FOXSPEED99/BleuLand-Smart-Energy-Meter/Bleu-Land/Smart-Energy-Meter/Enclosure/Labels/front_label_80x41mm_DIECUT.pdf

DIE-CUT: outline R1.5, LED holes Ø3.2 (rods Ø3.0)
