FOXSPEED99/BleuLand-Smart-Energy-Meter/Bleu-Land/Smart-Energy-Meter/Enclosure/Labels/rating_label_46x32mm.pdf

SEM-1 S M A R T E N E R G Y M E T E R

Supply | 230 V~ 50 Hz, ≤ 3 W
Measuring | 1-phase · CT 100 A / 50 mA (max 80 A)
Internal fuse T500mA L 250 V (5×20 ceramic)
Radio | Wi-Fi 2.4 GHz 802.11 b/g/n
Environment IP20 · −10 … +50 °C · indoor
Mounting EN 60715 TS35 · 5 modules
