FOXSPEED99/BleuLand-Smart-Energy-Meter/Bleu-Land/Smart-Energy-Meter/Enclosure/Labels/front_label_80x41mm.pdf

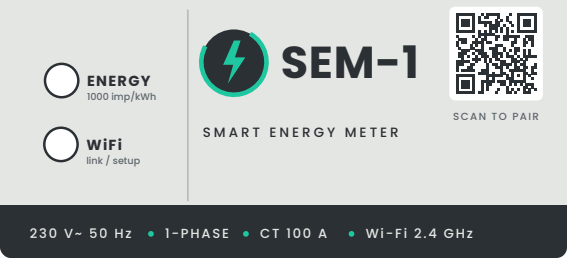
[picture p1: figure]
ENERGY; WiFi; 1000 imp/kWh; link / setup; SEM-1; SCAN TO PAIR; 1-PHASE; Wi-F i 2.4 GHz
