FOXSPEED99/BleuLand-Smart-Energy-Meter/Bleu-Land/Smart-Energy-Meter/Enclosure/Labels/front_label_80x41mm_DIECUT.png

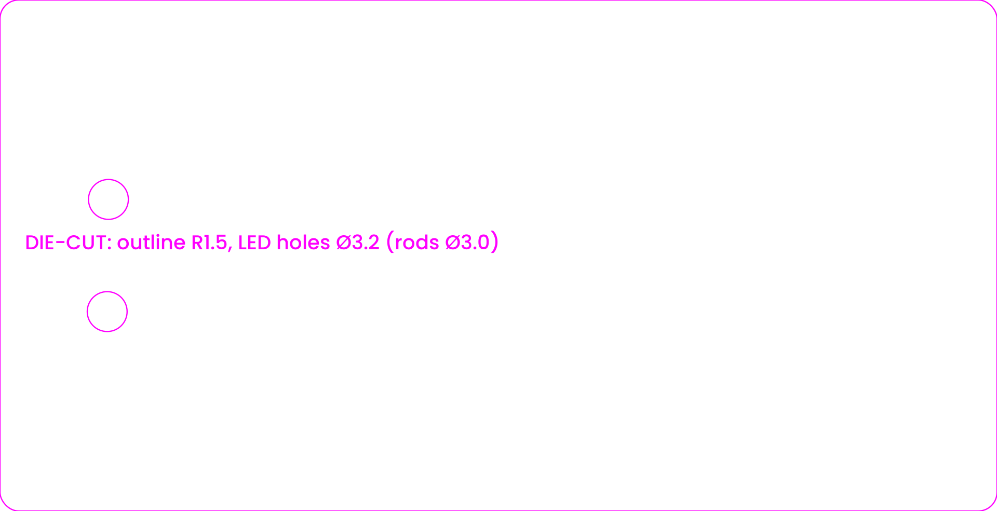
Bleu-Land/Smart-Energy-Meter/Enclosure/Labels/front_label_80x41mm_DIECUT.png
