FOXSPEED99/BleuLand-Smart-Energy-Meter/Bleu-Land/Smart-Energy-Meter/Enclosure/Labels/rating_label_46x32mm.png

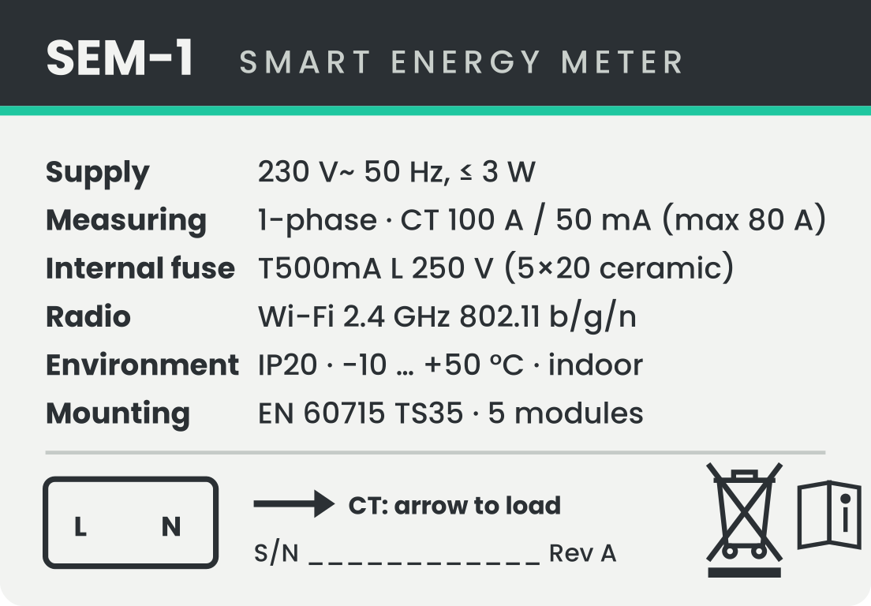
Bleu-Land/Smart-Energy-Meter/Enclosure/Labels/rating_label_46x32mm.png
