FOXSPEED99/BleuLand-Smart-Energy-Meter/Bleu-Land/Smart-Energy-Meter/Enclosure/Renders/SEM-1_front.png

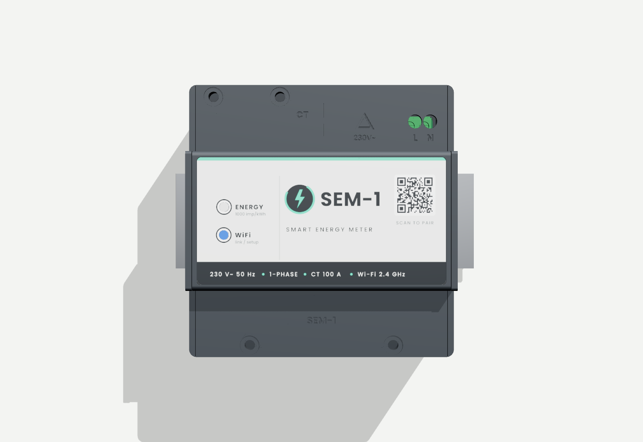
Bleu-Land/Smart-Energy-Meter/Enclosure/Renders/SEM-1_front.png
