FOXSPEED99/BleuLand-Smart-Energy-Meter/Bleu-Land/Smart-Energy-Meter/Enclosure/Renders/SEM-1_top.png

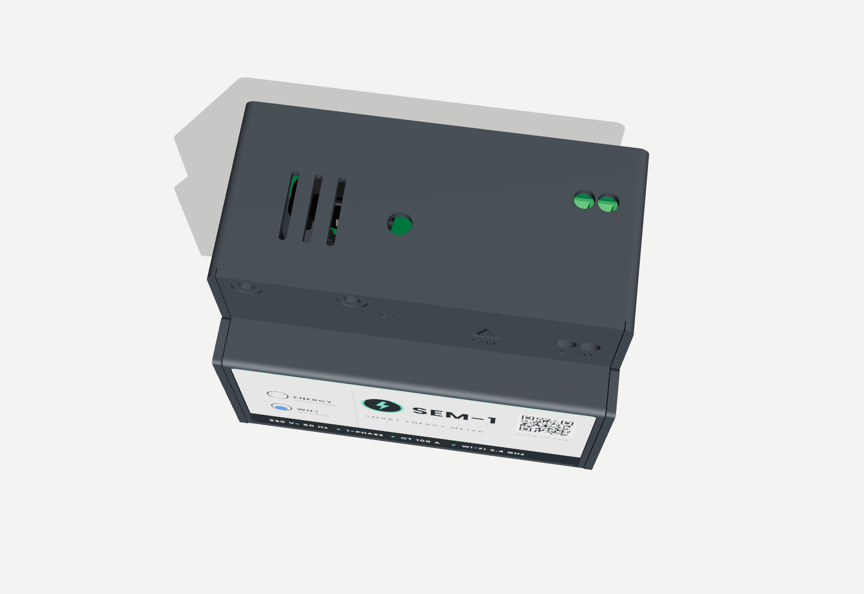
Bleu-Land/Smart-Energy-Meter/Enclosure/Renders/SEM-1_top.png
