FOXSPEED99/BleuLand-Smart-Energy-Meter/Bleu-Land/Smart-Energy-Meter/Smart-Energy-Meter_BOM_revA.xlsx

Sheet: PCB parts
Smart Energy Meter rev A: Bill of Materials
Meters to build: |  | 10 | ← edit this number (yellow); "Qty to order" updates. Source: Energy-Meter.SchDoc, 4 Oct 2026.
Line | Designators | Qty / meter | Value | Description | Manufacturer | Manufacturer Part Number | Footprint | Notes | Qty to order
1 | BT1 | 1 | BATT holder | BATTERY HOLDER COIN 20MM PC PIN | MPD | BH32T-C-G | BAT_BH32T-C-G | Holder only; CR2032 on Off-board sheet | 10
2 | C1 | 1 | 10 µF | General Purpose Ceramic Capacitor, 1206, 10uF, 10%, X5R, 15%, 10V | KYOCERA AVX | 1206ZD106KAT2A | FP-1206-L_3_2_0_2-W_1_6_0-MFG |  | 10
3 | C2, C6, C8 | 3 | 100 nF | CAP CER 0.1UF 25V X7R 1206 | KEMET | C1206C104J3RACTU | FP-C1206C-EB-MFG |  | 30
4 | C3 | 1 | 470uF | Capacitor, aluminium electrolytic, 470 uF, 10 V, 20%, radial D8x11.5mm, 3.5mm pitch, laid down | Rubycon | 10YXF470MEFC8X11.5 | CAPPRD350W60D800H1150_LAYDOWN | Mounted lying flat under the ESP32 | 10
5 | C4 | 1 | 100 nF | AR 100nF Ceramic Multilayer Cap,50V dc,+125C,X7R Dielectric,+/-10%,Through Hole AVX AR215C104K4R | AVX | AR215C104K4R | CAPRR508W50L508T318H762 |  | 10
6 | C5 | 1 | 0.1uF X2 | Capacitor 0.1uF +/-10%, 275 VAC class X2, MKP polypropylene film, 40/100/21, radial through hole, 15 mm pitch | TDK | B32922C3104K000 | CAPX2_L18.0-W6.0-H11.0_P15.00 | X2 safety cap, 305 VAC, 15 mm pitch | 10
7 | C7 | 1 | 10 µF | Chip Multilayer Ceramic Capacitors for General Purpose, 1206, 10uF, X7R, 15%, 10%, 25V | Murata | GRM31CR71E106KA12L | FP-GRM31C-0_2-e0_3_0_8-IPC_C |  | 10
8 | C9, C10 | 2 | 33 nF | CAP 33nF 50V ±5% 1206 (3216 Metric) Thickness 1.7mm SMD | Murata | GRM3195C1H333JA01D | CAPC1206(3216)170_N | C0G (stable filter cap) | 20
9 | C11, C12 | 2 | 10 nF | CAP CER 1206 .01UF 25V X7R 5% AU | KEMET | C1206C103J3RACAUTO | FP-C1206C-EB-MFG |  | 20
10 | D1 | 1 | LED 3mm Blue | LED, 3mm round, blue diffused, THT 2.54mm | Kingbright | WP710A10QBD/D | LED_D3.0MM_P2.54_BLUE | Blue, D1 only (active-low drive from 5 V) | 10
11 | D2 | 1 | LED 3mm White | LED, 3mm round, white diffused, THT 2.54mm | Kingbright | L-7104QWC-D | LED_D3.0MM_P2.54_WHITE | White, D2 only (active-low drive from 5 V) | 10
12 | D3, D4 | 2 | SMAJ5.0CA | TVS DIODE 5V 9.2V SMA | Bourns Inc. | SMAJ5.0CA | FP-SMAJ-MFG |  | 20
13 | F1 | 1 | Holder 5x20 + T500mA 250V | 5mm Slim Line Fuse holder | Keystone | 4628 | FUSE_4628 | Holder only; fuse insert on Off-board sheet | 10
14 | FB1 | 1 | Ferrite Bead | Chip Ferrite Bead, 1206, 600O @ 100MHz, 0.038O, 25%, 2.9A | Murata | BLM31KN601SN1L | FP-BLM31-0_2-T1_6-IPC_B |  | 10
15 | IC1 | 1 | DS1307 | Real Time Clock (RTC) I²C, 56 B RAM, 8-DIP | Analog Devices | DS1307+ | DIP794W47P254L991H457Q8 |  | 10
16 | J1 | 1 | B2B-XH-A | CONN HEADER VERT 2POS 2.5MM | JST | B2B-XH-AM(LF)(SN) | FP-B2B-XH-AM_LF_SN-MFG | CT connector on PCB | 10
17 | L1 | 1 | 744821110 |  | Wurth Elektronik | 744821110 | WE-CMB_Type XS_L15W7.5H18 | Common-mode choke 10 mH | 10
18 | P1 | 1 | Terminal Block | PCB terminal block, 2 positions, 5.08 mm pitch, through hole | TE Connectivity | 282837-2 | TE_282837-2 |  | 10
19 | PS1 | 1 | HLK-5M05 | AC DC 220V to 5V 5W 5Watt Isolated Switching Step-Down Power Supply Module Converter | Hi-link | HLK-5M05 | CONV_HLK-5M05 |  | 10
20 | R1, R9 | 2 | 330Ω | RES SMD 330 OHM 5% 1W 2512 | Yageo | AC2512JK-07330RL | FP-AC2512-MFG |  | 20
21 | R2, R3 | 2 | 4.7kΩ | RES SMD 4.7K OHM 1% 1W 2512 | Yageo | AC2512FK-074K7L | FP-AC2512-MFG |  | 20
22 | R4 | 1 | 100Ω | Res MC AT Precision Thin Film 1206 100O 0.1% 0.4W ±25ppm/°C Molded Paper T/R | Vishay | MCA1206MD1000BP100 | FP-MCA1206-IPC_A | ZMPT101B burden, 0.1% 25 ppm (check packaging suffix when ordering) | 10
23 | R5, R8, R10, R13 | 4 | 47k | Resistor, 47 kOhm, 1%, 0.25 W, metal film, axial THT, 7.62 mm pitch | YAGEO | MFR-25FRF52-47K | RESAD762W55L630D240_MF | Mains divider, metal film 1% | 40
24 | R6 | 1 | 2kΩ | RES Thick Film, 2kO, 1%, 1W, 100ppm/°C, 2512 | Vishay | CRCW25122K00FKEG | FP-CRCW2512-E3-IPC_A |  | 10
25 | R7 | 1 | 0Ω | 0O ±0 1W 2512 Thick Film Chip Resistor AEC-Q200 compliant | Stackpole | RMCF2512ZT0R00 | FP-RMCF2512-IPC_A |  | 10
26 | R11 | 1 | 1kΩ | RES Thick Film, 1kO, 1%, 1W, 100ppm/°C, 2512 | Vishay | CRCW25121K00FKEH | FP-CRCW2512-E3-IPC_A |  | 10
27 | R12 | 1 | 1kΩ | 1kO ±1% 0.25W 1206 Thick Film Chip Resistor AEC-Q200 compliant | Stackpole | RMCF1206FT1K00 | FP-RMCF1206-IPC_C |  | 10
28 | R14 | 1 | 0.5Ω | Chip Resistor, 0.5 Ohm, +/- 1%, 1 W, -65 to 275 degC, 2512 (6432 Metric), RoHS, Tape and Reel | Vishay | WSLT2512R5000FEA | RESC6432X89X76ML25T25 | CT burden, 0.5 Ω metal strip (100 A rating) | 10
29 | R15, R17 | 2 | 1.5kΩ | RES Thick Film, 1.5kO, 1%, 1W, 100ppm/°C, 2512 | Vishay | CRCW25121K50FKEG | FP-CRCW2512-E3-IPC_A |  | 20
30 | RV1 | 1 | MOV-10D561K | 560 V 2.5 kA Varistor 1 Circuit Through Hole Disc 10mm | Bourns | MOV-10D561K | VAR_MOV-10D561K |  | 10
31 | T1 | 1 | ZMPT101B | Current-type Voltage Transformer | Qingxian Zeming Langxi Electronic | ZMPT101B | XFMR_ZMPT101B |  | 10
32 | U1 | 1 | ESP32-DevKitC V4 | Espressif ESP32-DevKitC V4 (ESP32-WROOM-32E) dev board, socketed on 2x19 female headers | Espressif Systems | ESP32-DEVKITC-32E | ESP32-DEVKITC-V4_SOCKET | Plugs into 2 female headers (Off-board sheet) | 10
33 | U2 | 1 | HLW8032 | High-precision single-phase energy metering IC, dual sigma-delta ADC, UART 4800bps, PF pulse output, 5V, SOP-8 | Hiliwei Tech | HLW8032 | SOIC127P600X175-8N | LCSC C128023 | 10
34 | Y1 | 1 | 32.768kHz | Crystal 32.768 kHz, 12.5 pF, +/-20 ppm, tuning fork, 3 x 8 mm cylindrical can, through hole, vertical | Abracon | AB38T-32.768KHZ | XTAL_D3.2XL8.3_P2.00_VERTICAL |  | 10
 | Total parts per meter | 45

Sheet: Off-board items
Items you buy but do not solder as a schematic part
Meters to build: |  | 10
Line | Item | Qty / meter | Manufacturer | Manufacturer Part Number | Goes with | Notes | Qty to order
1 | Fuse 5×20 mm, T500 mA, 250 VAC, ceramic, time-lag | 1 | Littelfuse | 0215.500MXP | F1 holder | HLK-5M05 datasheet value | 10
2 | Lithium coin cell 3 V | 1 | Panasonic | CR2032 | BT1 holder | RTC backup | 10
3 | Split-core current transformer 100 A : 50 mA (current output, no internal burden) | 1 | YHDC | SCT-013-000 | J1 | Cut the 3.5 mm jack; crimp JST XH (tip wire → pin 2, sleeve wire → pin 1) | 10
4 | Female header 1×19, 2.54 mm, 8.5 mm tall | 2 | Sullins | PPTC191LFBN-RC | U1 (ESP32 DevKitC socket) | Check height: DevKitC must sit ≥ 9 mm above board for C3 | 20
5 | JST XH housing, 2 pin | 1 | JST | XHP-2 | CT cable to J1 |  | 10
6 | JST XH crimp contact, 22–28 AWG | 2 | JST | SXH-001T-P0.6 | CT cable to J1 | Order spares | 20
7 | Bare PCB 75 × 75 mm, FR-4 1.6 mm, 2 layers, 1 oz, HASL | 1 | (PCB maker) | Energy-Meter rev A | — | Order after Round K (release files) | 10
8 | DIN-rail enclosure | 1 | TBD | TBD (Round F) | — | Chosen in Round F | 10
