FOXSPEED99/BleuLand-Smart-Energy-Meter/Bleu-Land/Smart-Energy-Meter/Enclosure/STEP/SEM-1_enclosure_assembly.step

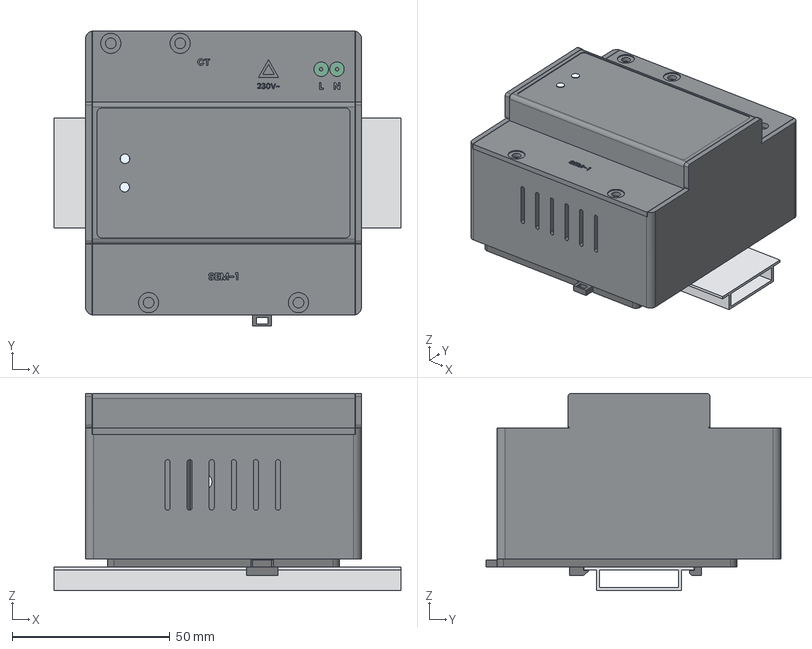
[picture p12: CAD file, 2026-10-08]
Bleu-Land/Smart-Energy-Meter/Enclosure/STEP/SEM-1_enclosure_assembly.step
110.0 x 93.5 x 62.5 mm
base
cover
din_foot
lightpipe_carrier
light_rods_PMMA
PCB_bare
TS35_rail_reference
