FOXSPEED99/BleuLand-Smart-Energy-Meter/Bleu-Land/Smart-Energy-Meter/Enclosure/STEP/base.step

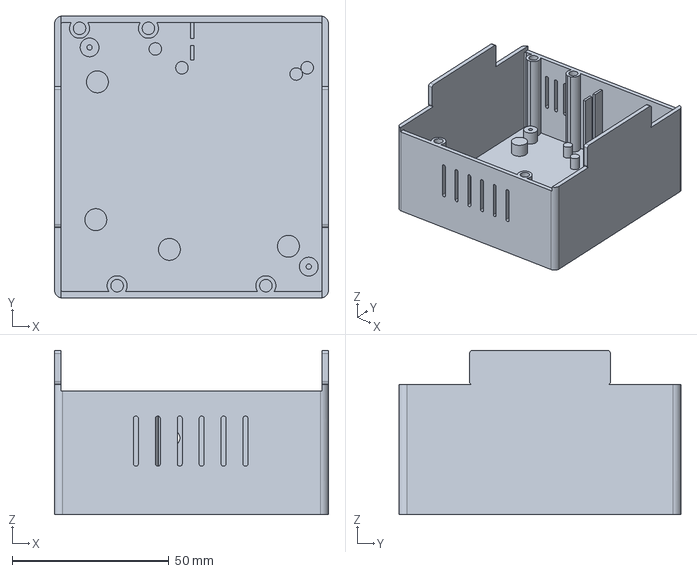
[picture p13: CAD file, 2026-10-08]
Bleu-Land/Smart-Energy-Meter/Enclosure/STEP/base.step
87.5 x 90.0 x 52.5 mm
