FOXSPEED99/BleuLand-Smart-Energy-Meter/Bleu-Land/Smart-Energy-Meter/Enclosure/STL_print_ready/03_din_foot__print_rail_side_up_PETG.stl

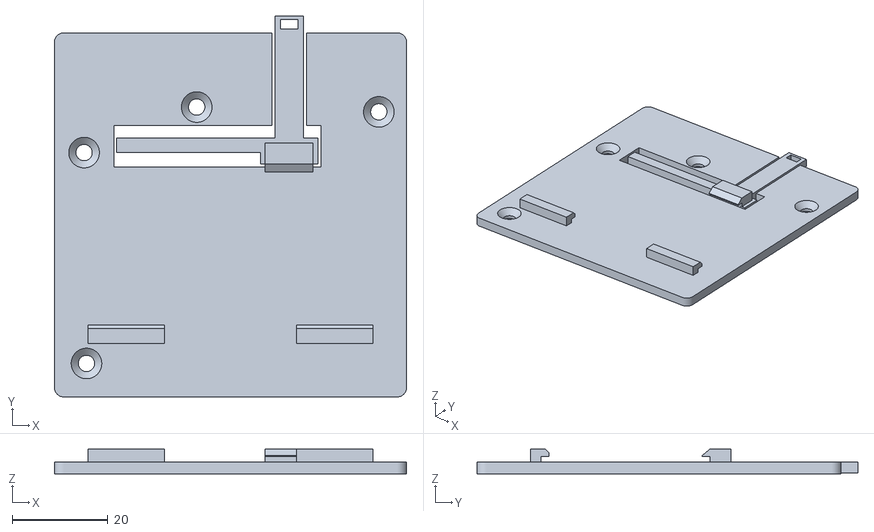
[picture p14: CAD file, 2026-10-08]
Bleu-Land/Smart-Energy-Meter/Enclosure/STL_print_ready/03_din_foot__print_rail_side_up_PETG.stl
73.5 x 79.5 x 5.20
