FOXSPEED99/BleuLand-Smart-Energy-Meter/Bleu-Land/Smart-Energy-Meter/Enclosure/STEP/lightpipe_carrier.step

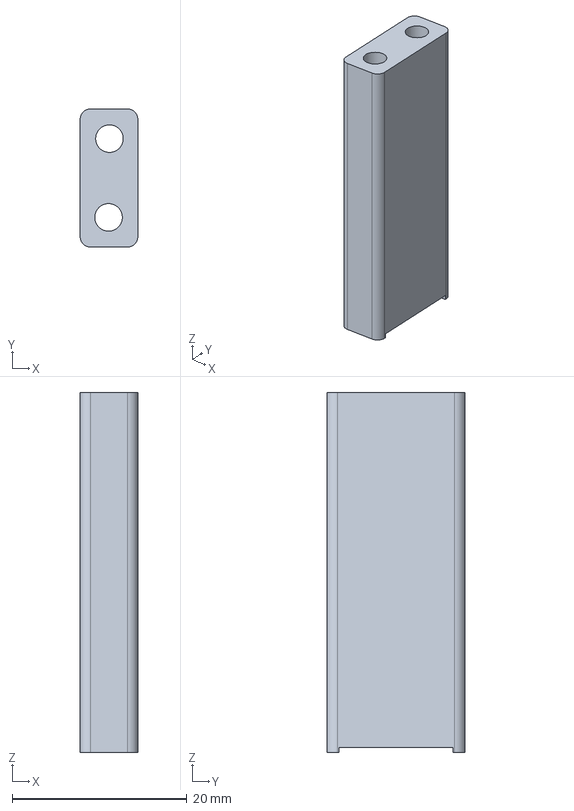
[picture p15: CAD file, 2026-10-08]
Bleu-Land/Smart-Energy-Meter/Enclosure/STEP/lightpipe_carrier.step
6.60 x 15.8 x 41.1 mm
