FOXSPEED99/BleuLand-Smart-Energy-Meter/Bleu-Land/Smart-Energy-Meter/Enclosure/STL_print_ready/02_cover__print_standing_on_end.stl

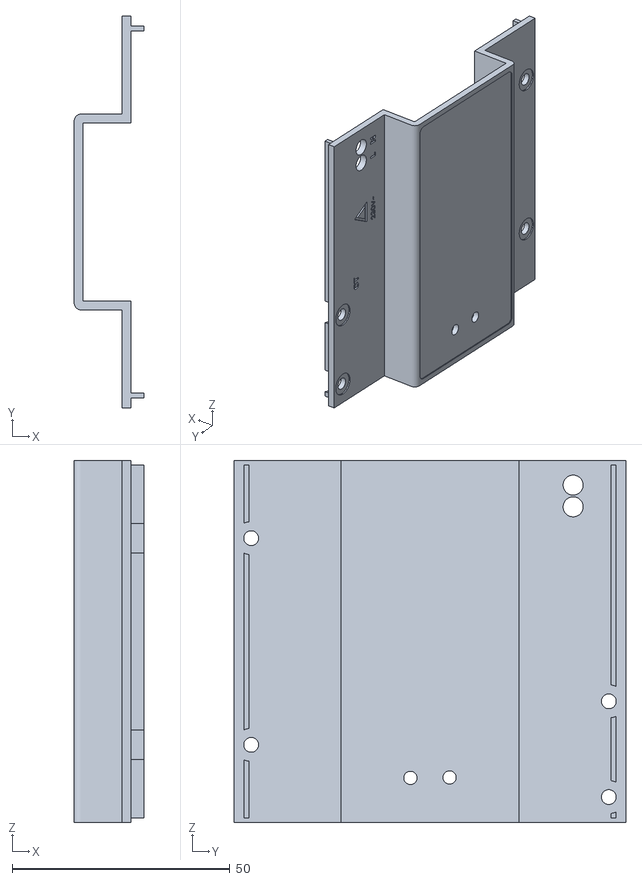
[picture p16: CAD file, 2026-10-08]
Bleu-Land/Smart-Energy-Meter/Enclosure/STL_print_ready/02_cover__print_standing_on_end.stl
16.0 x 90.0 x 83.2
