FOXSPEED99/BleuLand-Smart-Energy-Meter/Bleu-Land/Smart-Energy-Meter/Enclosure/STEP/light_rods_PMMA.step

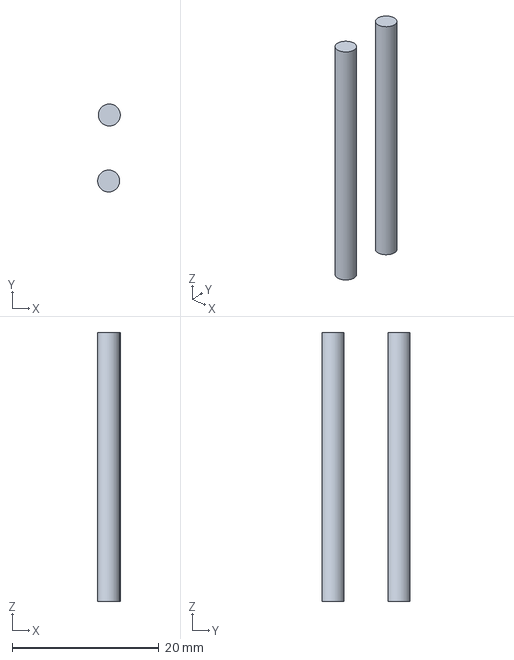
[picture p17: CAD file, 2026-10-08]
Bleu-Land/Smart-Energy-Meter/Enclosure/STEP/light_rods_PMMA.step
3.10 x 12.0 x 36.7 mm
