FOXSPEED99/BleuLand-Smart-Energy-Meter/(list of files, cad)

Other CAD files:
Bleu-Land/Smart-Energy-Meter/Enclosure/STL_print_ready/01_base__print_back_down.stl
Bleu-Land/Smart-Energy-Meter/Enclosure/STL_print_ready/04_lightpipe_carrier__print_upright.stl
Bleu-Land/Smart-Energy-Meter/Enclosure/STEP/din_foot.step
Bleu-Land/Smart-Energy-Meter/Enclosure/STEP/cover.step
