FOXSPEED99/BleuLand-Smart-Energy-Meter/(list of files, drawings)

Other design files:
Bleu-Land/Smart-Energy-Meter/Energy-Meter.PcbDoc
Bleu-Land/Smart-Energy-Meter/Energy-Meter.PcbLib
Bleu-Land/Smart-Energy-Meter/Energy-Meter.SchDoc
Bleu-Land/Smart-Energy-Meter/Smart-Energy-Meter.PrjPcb
Bleu-Land/Smart-Energy-Meter/Smart-Energy-Meter.SCHLIB
