FOXSPEED99/BleuLand-Smart-Energy-Meter/Bleu-Land/Smart-Energy-Meter/SEM1-Firmware/SEM1_Firmware/console.h

// Serial console (115200 baud) for the bench and the production line.
// Type "help" in the PlatformIO / Arduino serial monitor.
#pragma once

namespace console {
void begin();
void loop();
}  // namespace console
