FOXSPEED99/BleuLand-Smart-Energy-Meter/(commit log)

2026-10-08 Add SEM-1 production firmware (stage 1: metering, offline log, BLE WiFi setup)
    PlatformIO project (Arduino core 2.0.17) building for the DevKit prototype
    and the ESP32-C3 production board:
    - HLW8032 sliding-window decoder, 1 s averaging, P*dt and PF-pulse energy
    - energy counter backed up in DS1307 RAM, 5-min history ring in raw flash
    - NTP + DS1307 clock (UTC)
    - ESP BLE provisioning with per-unit PoP (QR) and a claim endpoint
    - LEDs per the front label, 5 s / 15 s button resets
    - local web page + JSON API, serial console
    - 15 PC unit tests for the metering core and flash log
    Claude-Session: https://claude.ai/code/session_01NsT6JB7eLs6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
    [partitions_sem1.csv]
2026-10-08 Switch firmware build from PlatformIO to the Arduino IDE
    - sketch folder SEM1_Firmware/ with all code in src/ and partitions.csv
    (picked up automatically by the esp32 2.0.17 core)
    - board pins and CT values chosen automatically from the selected board
    - clear error if the esp32 board package isn't 2.0.17
    - boot-time warning if the app ever outgrows its 1.75 MB flash slot
    - unit tests run with plain g++ (test/run_tests.sh), no PlatformIO needed
    - README rewritten with Arduino IDE steps
    Claude-Session: https://claude.ai/code/session_01NsT6JB7eLs6ZCwZyGvDf38
    [partitions.csv]
2026-10-08 Make the firmware a normal-looking Arduino sketch
    All code files now sit in the sketch folder so the Arduino IDE shows them
    as tabs, and the .ino has a real setup()/loop() that call sem1Setup() /
    sem1Loop() in main.cpp.
    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
2026-10-08 Support esp32 Arduino core 3.x (tested 3.3.12) and match Minimal SPIFFS layout
    - net.cpp: map provisioning calls to network_provisioning on core 3.x
    (wifi_provisioning on 2.0.17) and include esp32-hal-alloc-ble-mem.h so
    core 3.x keeps the BLE memory needed for phone setup
    - drop the "2.0.17 only" #error
    - partitions.csv: app slots now equal "Minimal SPIFFS" (2 x 1.875 MB) so the
    IDE size check is exact; history log 128 KB (~22 days), coredump kept
    - fix printf format warnings on RISC-V (uint32_t is long there)
    - README/brief updated; builds clean on 3.3.12 and 2.0.17 for ESP32 and C3
    Claude-Session: https://claude.ai/code/session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
    [partitions.csv]
2026-10-08 Fix BLE memory handling for every esp32 core version
    esp32-hal-alloc-ble-mem.h only exists in the newest 3.3.x cores, so older
    3.x builds failed. Define a strong extern "C" btInUse() returning true
    instead (honoured by 2.0.17 and all 3.x) and include the header only when
    present. This also fixes a latent 2.0.17 DevKit bug where the core's weak
    btInUse() returned false and freed the BLE memory before phone setup.
    Verified: builds on cores 2.0.17, 3.3.4 and 3.3.12 for ESP32 and ESP32-C3,
    and the linked btInUse comes from net.cpp and returns true.
    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
    [net.cpp]
2026-10-08 Start phone setup when saved WiFi came from other firmware
    On Fox's DevKit the old test sketch had left its hard-coded network in
    flash, so the provisioning manager reported "provisioned", BLE setup never
    started and the app found nothing. Now:
    - an NVS flag marks WiFi details that came through our own BLE setup;
    anything else is erased at boot and setup starts
    - boot log names the saved network and how to reset it
    - retry no longer interrupts phone setup and stops the current attempt
    before starting a new one (fixes "sta is connecting, return error")
    - README: app prefix (SEM1_) and troubleshooting
    Builds clean on cores 2.0.17, 3.3.4 and 3.3.12 for ESP32 and ESP32-C3.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
    [net.cpp, settings.cpp, settings.h]
2026-10-08 Fix "online" never detected after phone setup on core 3.x
    On Fox's DevKit the meter joined the WiFi (visible on the hotspot as
    "espressif") but the firmware never got the got-IP event, kept retrying
    and never started the web page. Core 3.x only routes IP events (and the
    hostname) through its STA interface once WiFi.STA.begin(false) has run,
    which Espressif's own WiFiProv does since 3.1. Use it on 3.x, keep
    wifiLowLevelInit on 2.0.17, and add a WiFi.status() fallback in loop().
    Retry message now shows the saved network name.
    Builds clean on cores 2.0.17, 3.3.4 and 3.3.12 for ESP32 and ESP32-C3.
    Claude-Session: https://claude.ai/code/se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
    [net.cpp]
2026-10-08 Add SEM-1 cloud schema migration (not yet applied)
    Supabase schema for project "sem1": devices, members, invites, live values,
    5-minute readings, alerts, all with row-level security; device_hello /
    device_push for meters (secret checked against a SHA-256 hash in a private
    schema), claim_device via the label QR proof of possession, sharing,
    and get_energy for hourly/daily/monthly totals.
    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
2026-10-08 Retarget cloud defaults to Syria, record project and market decisions
    - schema defaults: Asia/Damascus, SYP, empty tariff (user enters the
    brackets), billing period length configurable (period_months)
    - brief: Frankfurt project bleuland-energy, Syria market, English-only
    app, dark theme, grid-consumption scope
    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
2026-10-08 Firmware stage 2: connect the meter to the cloud
    - cloud.cpp: background task registers the meter (device_hello), then
    sends live values every 10 s and uploads the offline 5-minute history in
    batches of 48 (device_push); upload cursor kept in DS1307 RAM; backoff up
    to 5 min; auth errors retried every 10 min
    - HTTPS validated against 11 root CAs used by Cloudflare (cloud_certs.h,
    from the Mozilla list)
    - history log guarded by a mutex (main loop writes, cloud task reads)
    - cloud status on the web page, in `info`, and as the blue LED
    "cloud down" pattern
    Builds clean on cores 2.0.17, 3.3.4, 3.3.12 for ESP32 and ESP32-C3.
    Claud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
    [app.h, cloud.cpp, cloud.h, cloud_certs.h, config.h, console.cpp, local_api.cpp, main.cpp]
2026-10-08 Add the BleuLand Energy app (Flutter: Android, iOS, web)
    Dark design from the SEM-1 label (teal on charcoal, Poppins):
    - Welcome / sign-in / sign-up (Supabase e-mail + password), demo mode
    with a simulated Syrian home
    - Home: live power + usage ring, V/I/PF, "this bill" in SYP with the
    cheap-block progress bar and pace forecast, today vs yesterday,
    24 h power chart
    - History: day / week / month / year bar charts with totals and averages
    - Alerts: high-usage threshold, offline alert, alert history
    - Settings: meter info, rename, tiered electricity price editor (Syria
    default 300 kWh at 6 then 14 SYP per 2-month bill), family sharing
    - Add a meter: QR scan -> WiFi over BLE (Espressif s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
2026-10-08 App: drop unused permission_handler (broke the Android build)
    permission_handler_android now needs compileSdk 37, above what the
    Flutter template's Android Gradle plugin supports, so the APK build
    failed at checkReleaseAarMetadata. The app never used it: universal_ble
    requests the Bluetooth permissions and mobile_scanner the camera.
    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
2026-10-08 Firmware: bigger app slots so the cloud build fits (Sketch too big)
    On Fox's esp32 3.x core the stage-2 DevKit build was 1,985,389 bytes,
    over the 1,966,080-byte "Minimal SPIFFS" slot. The Bluetooth stack alone
    is ~680 KB, so this needs room rather than trimming:
    - partitions.csv: app slots 2 x 0x1F0000, matching the IDE's
    "No FS 4MB (2MB APP x2)" scheme; datalog 64 KB (~11 days at 5 min,
    was 22); coredump partition dropped
    - remove mDNS (.local name, ~37 KB): nothing uses it and Android
    browsers don't resolve .local; the Serial Monitor prints the IP
    Now DevKit 94% / C3 77% on 3.3.12 (93% / 74% on 3.3.4); 2.0.17 builds
    with "Huge APP". Firmware unit tests pass. README and brief updat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
    [partitions.csv]
2026-10-09 Cloud: fast live mode while the app watches, voltage tracking and alerts
    - devices: watch_until, normal voltage range (volt_min/volt_max, default
    200-230 V, owner-editable), low/high state
    - watch_device(p_id): app heartbeat; device_push then returns fast=true
    and the meter uploads every 2 s for the next 45 s
    - device_push takes vmin/vmax (lowest/highest 1-s voltage since the last
    upload), keeps today's extremes in volt_days and the live row, and
    raises volt_low/volt_high alerts: 60 s outside the range -> severity 1,
    more than 10 V outside -> severity 2 (high voltage at once); closes with
    2 V of margin; readings under 100 V (no mains) ignored
    - Both migrations applied; behaviour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
2026-10-09 Firmware 0.2.0: 2 s live updates while watched, voltage dips and spikes
    - The cloud task uploads every 2 s while device_push answers fast=true,
    otherwise every 10 s (same keep-alive TLS connection)
    - Each upload carries the lowest/highest 1-s voltage since the previous
    one (readings under 100 V = no mains are left out), so short dips and
    spikes reach the voltage alerts
    - Builds: DevKit 94%, C3 77% on core 3.3.12; 2.0.17 also builds
    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
    [app.h, cloud.cpp, config.h, main.cpp]
2026-10-09 App: live card redesign, smooth live updates, voltage card and alerts
    Fox's notes on the Home screen:
    1. Live/Offline pill moved into the card's corner, clear of the ring
    2. "Only standby and the fridge" replaced by a usage level from watts
    (light <1 kW, moderate 1-3, high 3-5, very high >5) and how it
    compares with today's average; no device guesses, no prices
    3. Offline shows "-- W, unknown right now" with the last reading and its
    age, never 0 W; the card re-checks every 5 s, so it turns offline even
    when no new value arrives
    4. Home tells the cloud it's watching (every 25 s, only while visible and
    in the foreground): readings arrive every 2 s; numbers, ring and
    voltage d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
2026-10-09 Cloud: firmware updates over WiFi (releases, requests, progress)
    - Public "firmware" storage bucket and firmware_releases (per board,
    beta/stable, URL, size, MD5); written only by GitHub Actions
    - devices: fw_channel (stable/beta) and update state
    - firmware_status / request_update / cancel_update for the app (owner
    only for changes), device_ota for the meter's progress reports
    - device_push hands the meter {ota: version, url, size, md5} once the
    owner asked; device_hello after the restart marks done, failed (the chip
    rolled back) or retries an interrupted download (3 times)
    - Applied; full flow tested in a rolled-back transaction. Fox's meter is
    on the beta channel
    Co-Authored-By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
2026-10-09 Firmware 0.3.0: updates over WiFi with automatic rollback
    When the owner taps Update, the meter downloads the new firmware into
    its spare slot while it keeps measuring, checks size and MD5, and
    restarts. The new image stays on probation (verifyRollbackLater) until
    it reaches the cloud; a crash or 10 minutes without the cloud sends the
    bootloader back to the previous version. Console: "ota".
    GitHub Actions "Firmware: build & publish" builds DevKit and C3 on core
    3.3.12, runs the unit tests, keeps the .bin files as artifacts and,
    with the SUPABASE_SECRET_KEY secret, publishes them (main -> stable,
    other branches -> beta).
    Claude-Session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
    [cloud.cpp, config.h, console.cpp, main.cpp, ota.cpp]
2026-10-09 Cloud: change the meter's WiFi from the app
    - request_wifi_setup (owner): the next device_push answers
    {wifi_setup: true} once (requests older than 2 min are dropped)
    - device_push stores the WiFi name (device_live.ssid)
    - claim_device keeps the label code in private.device_setup_codes;
    get_setup_code (owner only) returns it for Bluetooth setup
    - Applied and tested in a rolled-back transaction; Fox's code stored
    after checking it against the meter's registered hash
    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
2026-10-09 Firmware 0.4.0: change WiFi from the app, recover after a password change
    A "setup window" restarts the meter into the usual Bluetooth phone setup
    with the working WiFi saved as a backup. If no new WiFi works before the
    window closes (or the power fails meanwhile), the backup is put back.
    It opens when:
    - the app asks (cloud "wifi_setup"), or the button is held 5 s, or the
    console "wifi-setup": 10 minutes
    - the saved WiFi has been unreachable for 2 minutes (password changed,
    new router): 4 minutes, then the old WiFi is tried again
    Holding the button no longer erases the WiFi. Live uploads include the
    WiFi name.
    Claude-Session: http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
    [cloud.cpp, config.h, console.cpp, main.cpp, net.cpp, net.h, settings.cpp, settings.h]
2026-10-09 App: plain "Offline" on Home, no numbers or WiFi button
    Fox's feedback: when the meter is offline the live card now shows just
    "Offline" and one line, with "Last seen 3 h ago" in the corner pill. No
    dashes, no last reading, no voltage/current/power-factor row, and no
    "Changed your WiFi?" button: changing the WiFi lives in Settings -> WiFi.
    The Voltage card shows "Offline" instead of dashes and keeps today's
    lowest/highest.
    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
2026-10-09 App: tidier offline Home (no Voltage card, last-seen pill as title)
    Fox's feedback:
    - the Voltage card hides itself while the meter is offline (it shows
    "No mains voltage" only when the meter reports but has no mains)
    - the note is back to "The meter may have lost power or internet..."
    - offline, "Using now" is replaced by the "Last seen 4 h ago" pill in
    the same spot, with "Offline" right under it; no pill in the corner
    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
2026-10-09 App: offline card styled like the live card, one-line note
    When the meter stops reporting, Home shows its own card with the same
    layout as the live one: an "Offline" pill in the corner, "Last seen /
    4 h ago" as the big text, "No power or internet" as the only note, and
    an empty coral gauge with a soft pulse while the app waits for it.
    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
2026-10-09 App: offline card with a small "last seen" line instead of a huge time
    The time was as big as the live watts and looked heavy. Now "Last seen
    4 h ago" is the small grey label at the top and "No power or internet"
    is the headline, beside the empty coral gauge.
    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
2026-10-09 App: offline card without the gauge, one-line title and a short reason
    Fox's notes:
    - the empty half-circle gauge around the icon is gone; the icon sits in
    a soft circle that breathes, with ripples that fade in and out so the
    loop never jumps
    - "Last seen 4 h ago" and the Offline pill share one row
    - "Meter is offline" (one line) with "Power or internet may be down."
    under it
    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
2026-10-10 Home: calmer voltage card, range moved to Settings, aligned live title
    - live card: no "4.7x your average today" line; "Using now" and the Live
    pill now sit on one row
    - voltage: up to 3 V past the range counts as normal (230.1 V on a
    200-230 V range is within the meter's tolerance), in the app and in the
    cloud alerts (migration 20261010090000_volt_grace, applied and tested)
    - voltage card: no today's-min/max ticks on the bar, lowest/highest each
    centred in their half, no edit button; the normal range is now changed
    in Settings -> Normal voltage
    Claude-Session: https://claude.ai/code/session_01NsT6JB7eLs6ZCwZyGvD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
2026-10-10 App: voltage card layout, range beside the title, stats at the edges
    - "Normal 200-230 V" sits on the title row, the status chip moves next to
    the live value (so neither corner is empty, with or without mains)
    - a little more space between the title and the value
    - lowest today on the left edge, highest today on the right edge, lined
    up with the ends of the bar
    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
2026-10-10 App: simpler voltage card, no lowest/highest, bolder bar
    Fox: too many numbers, people won't know where to look.
    - lowest/highest today removed from the card
    - the bar is twice as thick with rounded ends; the zone the live value
    is in is bright and the others dimmed, so the eye goes straight to it
    - a bigger dot with a soft shadow, and a little more space above the bar
    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
2026-10-10 App: voltage card with a needle, one-line notes and a blue wash
    - the live value is a slim white needle across the bar instead of the
    ringed dot
    - the notes under the bar are one short line (the chip already says how
    low or high it is), and never wrap: they shrink a touch on very narrow
    phones instead
    - a soft blue gradient in the corner, like the live card's green one
    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
2026-10-10 App: voltage card tint follows the status instead of blue
    Fox didn't like the blue. The corner wash is now green when the voltage
    is normal (same as the live card), amber when it's a bit off, red when
    serious, and plain with no mains. It fades between them.
    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
2026-10-10 App: voltage card shade from the top-right corner
    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
2026-10-10 Shows 0 W when nothing is on (ignores small noise under 25 W)
    Firmware 0.4.1. With the clamp around nothing the current input picks up
    up to ~20 W of noise (measured by Fox), which showed as a few watts and
    slowly added fake energy. A 1-second power under 25 W now reads as 0 W
    and 0 A and adds no energy; once a real load is seen it stays on down to
    20 W, so a load near the limit doesn't flicker. Unit test added; builds
    for both boards (DevKit 95 %, C3 76 %).
    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
    [config.h, main.cpp, meter.cpp, meter.h]
2026-10-10 Ignores short noise spikes: a load must last 3 seconds to show
    Firmware 0.4.2. After 0.4.1 the meter stayed at 0 W most of the time, but
    the 5-minute records still showed single-second noise spikes of 25-28 W
    (p_max 25-28 W while p_avg was 0-1 W), which flashed briefly in the app.
    A load now has to stay above 25 W for 3 seconds in a row before it shows;
    the energy of those 3 seconds is then counted, so real loads lose
    nothing. Turning off is unchanged (below 20 W). Unit test updated; builds
    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
    [config.h, meter.cpp, meter.h]
2026-10-10 App: hide the voltage card when there's no mains
    When the meter reports under 100 V (no mains, e.g. powered from USB) the
    card used to say "No mains voltage" with an empty bar; now it's hidden,
    like when the meter is offline.
    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
2026-10-10 App: meter turns "offline" on its own, within about 30 s
    Fox: Home kept showing "Live" long after the meter was switched off,
    until a few pulls to refresh. The timer that re-checks the reading's age
    was a lazy `late final` field that only dispose() touched, so it never
    started; the card only re-checked when something else rebuilt it. Both
    the live card and the voltage card now start their timer in initState
    and re-check every 2 s, and "offline" comes after 30 s without a report
    instead of 45 s (the meter reports every 10 s, every 2 s while the app
    is open).
    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
2026-10-10 App: chart values show in the title row and stay after lifting the finger
    Fox: the floating tooltip sat under the finger and vanished on release,
    fine with a mouse but not on a phone. Both charts (Home power, History
    energy) now:
    - show the touched value and time in the chart's title row, above the
    chart, so the finger never covers it
    - keep the pick after the finger lifts, with a x to clear it
    - follow the finger while sliding (the nearest point in time for the
    power line; anywhere in a bar's column for the bars)
    - show the peak there when nothing is picked
    The power line keeps the same moment picked when new data arrives;
    the bars reset when you change period.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
2026-10-10 App: power chart guide line runs the full height
    So the picked moment is easy to see even when the power there is 0 W.
    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
2026-10-10 App: chart zoom (24 h / 6 h / 1 h), step arrows, and time labels back
    Fox: the 24 h power chart packs 288 points into the width, so picking a
    moment misses often.
    - Home power chart: 24 h / 6 h / 1 h chips under it; at 1 h the 12
    five-minute points get dots and plenty of room. The picked moment is
    kept when switching range or when new data arrives.
    - Picked readout takes the whole title row: < value - time > and x.
    The arrows step one point (5 min, or one bar on History); hold to
    keep stepping.
    - Time labels under the power chart were missing whenever the first
    point wasn't on the hour (fl_chart places them from minX); x is now
    minutes since midnight, so they land on 00:00 / 06:0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
2026-10-10 App: Home power chart redesigned (soft area with a bubble)
    Fox picked option D from the mockups:
    - a lighter teal line with a soft gradient fill and faint grid lines
    - a bubble above the line marks the peak ("Peak · 19:00") until you tap
    or slide; then it shows that moment's real value and stays put, with
    a glowing dot and a dashed guide down to the axis
    - 24 h uses 15-minute slots, lightly smoothed (never across a gap) so
    the fridge switching on and off doesn't zig-zag the line; the bubble
    always shows the real average. 6 h and 1 h show the meter's own
    5-minute records (dots at 1 h)
    - times when the meter wasn't reporting are drawn as gaps instead of a
    straight line across
    - <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
2026-10-10 App: more room above the power line so the bubble doesn't hide its dot
    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
2026-10-11 App: works without internet, showing the last saved data
    Fox: open the app with no internet and still see everything except the
    live values, and say it's the phone that's offline, not the meter.
    - OfflineCache (SharedPreferences) keeps the raw rows of the last meters,
    energy (bill + history pages, at most 40), 24 h power and alerts
    queries; without network the same parsing runs on the saved rows. A
    server error is not treated as offline. Signing out clears it.
    - phoneOfflineProvider: the phone's network (connectivity_plus) or the
    last cloud request failing (Wi-Fi with no internet). The 25 s Home
    heartbeat doubles as the "is it back?" check.
    - Home: "You're offline / Connect your ph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
2026-10-11 App: sign every APK with one permanent key so updates install over the old app
    Fox: every update said "package conflicts with an existing package", so
    he had to delete the app (and sign in again) each time. The release build
    used the debug key, which GitHub creates fresh on each build machine, so
    no two APKs had the same signature.
    - build.gradle.kts signs release builds with the key at
    ANDROID_KEYSTORE_PATH (alias "upload") when it's given; local builds
    without it still fall back to the debug key.
    - CI writes the key from the ANDROID_KEYSTORE_BASE64 /
    ANDROID_KEYSTORE_PASSWORD secrets to the runner's temp folder (never the
    repo), warns if they're missing, and prints the APK's signat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
2026-10-11 CI: read the APK's signature with apksigner, after the upload
    keytool -printcert can't read the newer APK signature scheme, so the step
    found nothing and failed the run (the APK itself built fine). It now runs
    after the upload and can't fail the build.
    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
2026-10-11 App: offline opens instantly and is noticed while the app is open
    Fox: offline the app took a long time to show the saved values, and
    turning Wi-Fi off with the app open went unnoticed until a refresh.
    - Saved data comes back at once when the phone is known to be offline
    (Wi-Fi and data off, or the cloud already unreachable) instead of after
    a request that can't get through (an expired login could stall each
    one for the full 20 s timeout). Requests now give up after 8 s.
    - The "can the cloud be reached" state is remembered between launches,
    so an app last used offline opens on the saved data straight away and
    the first check corrects it.
    - Any change of the phone's network (Wi-Fi o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
2026-10-11 Firmware 0.4.3: go back to the home WiFi as soon as it's on again
    Fox: after the router went off the meter opened Bluetooth setup (slow
    blue blink) and didn't reconnect when the WiFi came back. In that setup
    window the old WiFi was only tried again after 4 minutes, then Bluetooth
    went away for 2 minutes while it tried, and so on.
    - Setup opened because the WiFi was unreachable now keeps trying that
    WiFi every 30 s in the background and restarts on it as soon as it
    works. The tries pause while a phone is connected over Bluetooth (the
    app's network scan fails while the meter is busy joining), and the
    Arduino library's own non-stop retries are off during setup.
    - That setup now stays op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
2026-10-11 App: keep the Home chart and today's numbers up to date
    Fox: the meter had been reporting for 3 hours, but the power chart still
    said "Not enough data yet". The chart and the bill numbers were loaded
    once when Home opened (here while the meter was offline) and never again,
    unless you pulled down to refresh.
    - They now reload every 5 minutes while Home is open (the meter adds a
    record every 5 minutes), and when you come back to Home or to the app.
    - "3840 % vs yesterday": when today is more than 4x yesterday at the same
    time, it means yesterday had little data, so the Today card shows
    "Yesterday 0.04 kWh" instead of a huge percentage.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
2026-10-11 App: power chart was empty because the readings came newest first
    Fox: the Home power chart said "Not enough data yet" although the meter
    had reported every 5 minutes for hours. The readings query used
    .order('ts'), which in the Supabase library means newest first; the chart
    took the last item (the oldest reading) as "now" and found nothing around
    it.
    - Ask for the readings oldest first, and the chart sorts them itself too.
    - The meter list is also asked for oldest first (order added).
    - Regression test with Fox's real readings of 10-11 Oct, newest first,
    at 24 h / 6 h / 1 h.
    Claude-Session: https://claude.ai/code/session_01NsT6JB7eL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
2026-10-11 Firmware 0.4.4: ignore misread power readings (1,422 kW from a 38 W load)
    Fox: the app showed 1,422 kW "Very high use" with 222.6 V and 0.17 A
    (a ~38 W load), and the history had 65,535 W peaks with 4-8 kW averages
    several times an hour, adding whole kWh to the bill. Now and then the
    HLW8032's power register is misread (a tiny period value gives a huge
    power) for a single packet.
    - Values this meter can't measure (over 400 V, 120 A or 30 kW) are
    replaced by the last good ones.
    - Power that voltage x current can't explain (more than V x I + 30 % +
    10 W) is replaced by the last good power, for at most ~0.5 s in a row;
    after that the reading is trusted again, so a badly calibrated meter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
2026-10-11 Energy totals and the chart ignore the power misreads of older firmware
    The misread power of firmware before 0.4.4 (peaks stuck at 65535 W, a few
    seconds of megawatts) had been added to the meter's energy counter: the
    October bill showed 9.59 kWh for a ~60 W load (really 0.80 kWh), 7.10 kWh
    on 9 Oct (really 0.56).
    - Cloud (get_energy, applied): a record can't hold more energy than its
    peak power allows over its interval, and a record with a misread peak
    counts the typical energy of the good records within an hour around it.
    The raw readings are unchanged.
    - App: those records are left out of the power chart instead of drawing
    4-8 kW spikes.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
2026-10-11 App: power chart shows the last 24 hours hour by hour, 12-hour times
    Fox: the chart had glitches (lines going back in time at 1 h, broken
    into dots at 6 h, axis labels wrapping), 1 h / 6 h aren't needed, and
    times should be 12-hour (2 PM, not 14).
    - One view: the last 24 hours, one point per hour (the average of the
    5-minute records), so short spikes and missing records no longer break
    the line. An hour with no neighbours shows as a dot; hours without
    readings stay empty. Labels 12 AM / 6 AM / 12 PM / 6 PM, the bubble
    shows "62 W · 2-3 PM" (the busiest hour until you pick one), and the
    axis is in W for small loads ("Power, W"), kW from 1 kW.
    - 24 h / 6 h / 1 h chips removed.
    - 12-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
2026-10-11 App: "Power today" chart in two halves, AM and PM, hours 1-12
    Fox's design for the Home chart:
    - Today hour by hour, in two pages of 12 hours: AM and PM. Swipe the
    chart or use the ‹ AM › switch in the title row; it opens on the half
    that "now" is in. Same scale on both halves.
    - Every hour labelled under its point, 1 … 12 (the hour it ends on, like
    a clock face); the busiest / picked hour is white and bold, the current
    hour teal. The bubble says "1.47 kW · 1-2 PM". Tap an hour to move the
    bubble there, tap it again to go back to the busiest.
    - No y-axis numbers or grid, just a baseline.
    - Only today's hours, so yesterday's leftovers (the stray dot and the
    little line at t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
2026-10-11 App: power chart gets faint guide lines and a clock before the hours
    Fox: the straight guide lines made the chart look better, and the 1 … 12
    need something saying they're hours.
    - Three faint horizontal lines above the baseline (still no numbers).
    - A small clock icon at the bottom left, before the 1.
    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
2026-10-11 App: power chart grid, and the clock lined up with the hours
    Fox: try a grid instead of only straight lines; the clock icon wasn't
    aligned with the numbers.
    - A faint grid: a vertical line on every hour plus the four levels.
    - The clock is now drawn in the hour-label row itself (left of the 1),
    so it sits exactly on the numbers' line, with room so it isn't clipped.
    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
2026-10-11 App: power chart grid of equal squares, a little fainter
    Fox: make the grid cells square and lower the opacity a bit.
    - The level lines are now spaced exactly like the hour columns, worked
    out from the chart's size on screen, so every cell is a square.
    - Grid lines at 60 % of the hairline colour.
    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
2026-10-11 App: one continuous day chart you glide through, and a live wave
    Fox: there were two bubbles (one tapped, one on the other half), 12 and 1
    weren't joined, the History link is already in the bottom bar, the title
    could be better, and the AM/PM switch was too big; keep the app feeling
    alive.
    - The chart is now one line across the whole day (so 12 and 1 join) in a
    horizontal scroller showing 12 hours at a time. A glide or flick settles
    on the morning or the afternoon; ‹ AM › animates there too. Only one
    bubble: the busiest hour of the half in view, or the hour you tapped.
    Near the edge the bubble opens inwards so it's never cut off.
    - Opens on the half "now" is in, unless that's sti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
2026-10-11 Settings: "Reset usage data" to start fresh
    Fox: a reset in Settings to clear the bill, the usage and so on and start
    again.
    - Settings -> Start fresh -> Reset usage data (owner only, not in the
    demo). The dialog lists what goes (bill so far, energy history, charts,
    alerts) and what stays (the meter, name, price, voltage range, WiFi,
    sharing); Reset only works after ticking "I understand this can't be
    undone". Afterwards the phone's saved copy is cleared too and Home,
    History and Alerts reload from zero.
    - Cloud (migration added, not applied yet): reset_device_data() deletes
    the meter's readings and alerts for its owner and remembers when; a
    trigger drops records from before th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
2026-10-11 App: no more "Meter is offline" after switching back to the app
    Fox: every time he switched to another app and back, Home said the meter
    was offline (last seen 3 minutes ago) until a pull-to-refresh, although
    it was online. Android closes the live connection while the app is in
    the background, so no new readings arrived and the last one aged.
    - Coming back to the app reconnects the live stream and fetches the
    current reading at once.
    - While Home is open, if no live update arrived for 30 s the stream is
    reconnected on the next 25 s check (a connection that died quietly).
    - Each live subscription gets its own channel name, so a reconnect never
    collides with the one still closing.
    Co-Au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
2026-10-12 App: "Current bill" with a plain price line and a waving flag; country picker
    Fox: move the bill title up, rename it, make the price note clearer and
    drop the lonely "then 14", put the country's flag there with a smooth
    loop, and let people choose their country (Syria now, more later).
    - Bill card: "Current bill", a bit closer to the top. One line about the
    price: "6 SYP per kWh for the first 300 kWh" (or "Over 300 kWh: now
    14 SYP per kWh", or "6 SYP per kWh" with a single price); it shrinks
    rather than wraps. The flag waves on the right.
    - WavingFlag: drawn in code (Syria: green / white / black, three red
    stars) in ~1 px slices with light and shade on the folds, rounded
    corners; p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
2026-10-12 App: Match your bill (Syria) in Settings
    Optional: enter the house meter reading now and, if you have it, the
    last bill's current reading. The bill on Home then covers the whole
    2-month cycle, including the days before the BleuLand meter was
    installed (exact with the bill reading, estimated from daily use
    without it). The screen also shows what the house meter should read
    now. Regions carry a billMatch flag so it only appears for Syria.
    The price screen keeps the match when saving. Adds BillMatch tests.
    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
2026-10-12 App: History redesign: cost per period, a label under every bar, highlights
    Fox: replace "Per hour" with something useful like the cost, give the
    cards some life, keep the green bars but name each one, drop the 0 / 0.2
    / 0.4 axis.
    - Used + Cost cards with coloured badges; numbers count up. Cost is what
    the period added to the bill: price blocks restart every cycle, so each
    bar is priced at where its cycle stood (Tariff.priceInOrder, also with
    "Match your bill"). Used shows the change vs the period before, up to
    the same point; Cost shows the average price per kWh.
    - New bar chart (UsageBars): every bar has its hour / day / month under
    it (12 1 2 ... with an AM / PM bracket; Mon 6;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
2026-10-12 App: stop the offline note blinking on a patchy connection
    Fox: with Wi-Fi working, Home kept flipping to "You're offline" and back
    every few seconds. One request that timed out (normal on a slow line)
    set offline; the next live update set online again, which reloads
    everything at once, and one of those reloads timing out set offline
    again: a loop.
    - CloudReach: a failure only counts when nothing got through for 30 s
    (live updates arrive about every 10 s, so while they flow it stays
    online). Real loss of internet still shows within about a minute.
    - Network: Wi-Fi / data reported gone only after 4 s, so a short
    hand-over blip doesn't flash the note. Switching Wi-Fi off still shows
    it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
2026-10-13 App: Match your bill estimates from whole days, and shows ≈ when it does
    Fox's bill jumped from 6 to 681 kWh overnight. He matched without the
    last bill's reading, so the days since 1 Sep were estimated, from the
    first 12 hours after matching: a heavy night (8.3 kWh in 12 h = 16
    kWh/day) times 42 days. A whole day measured 4.9 kWh.
    - typicalDailyKwh: the average of whole days the meter measured (not
    today, not the first part-day after install or a reset); no estimate
    until there's one such day.
    - Home bill: "≈" before kWh and cost while part of it is estimated.
    Claude-Session: https://claude.ai/code/session_01NsT6JB7eLs6ZCwZyGv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
2026-10-13 App: Match your bill takes the last bill's amount; numbers typed with commas
    Fox: people pay the bill in Sham Cash, so the amount is at hand even
    without the paper bill's reading. And type "1,020,359,584", not
    "1020359584".
    - New optional field "Last bill: amount paid". Tariff.kwhFor turns an
    amount back into kWh, block by block (1,431.69 SYP ≈ 239 kWh); over the
    days of the cycle before (Jul–Aug: 62) that's the day's use for the
    estimate. Order: bill reading (exact) > amount > the meter's own days.
    Saved as bill_match.last_bill_amount; "Update the numbers" keeps it.
    - GroupedNumberFormatter: thousands commas while typing, cursor kept
    after the same digit; 2 decimals for the am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
2026-10-13 App: no estimates in the bill: exact numbers or measured ones only
    Fox: "we are working on a production device, we should be precise with
    everything". The days before the meter were guessed (from its first
    days, or from the last bill's amount) and shown with "≈".
    - Match your bill now needs the last bill's current reading: before the
    meter = house meter - that reading, exact; the rest is measured. The
    amount field and every estimate (typicalDailyKwh, kwhFor,
    dailyFromLastBill) are gone; no "≈" anywhere.
    - A match saved without the reading shows "One number missing" and the
    bill counts only what the meter measured until it's added.
    - The row shows where the number comes from (106,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
